ThaneGallo/GuitarPedal/(threads)

Thread 3 (2025-05-18):

Setup ADC within STM32 For testing

ThaneGallo, 2025-05-18:
After the initial amplifier is made and tuned you can begin testing to get the queues to move the data correctly

Just verify it moves from one place to another

Closed 2025-06-08.
