ThaneGallo/GuitarPedal/Code/Core/Src/main.c

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
/* Includes ------------------------------------------------------------------*/
#include "main.h"

/* USER CODE BEGIN Includes */

#include "PCM1802.h"
#include "dsp.h"



// #define ADC_BUF_LEN 16384
// #define HALF_BUF_LEN 8192

static uint16_t adc_buf[ADC_BUF_LEN];
static uint16_t dac_buf[ADC_BUF_LEN];

static float processing_buf[HALF_BUF_LEN];


// flags
uint8_t process_first_half = 0;
uint8_t process_second_half = 0;

/* USER CODE END Includes */

ADC_HandleTypeDef hadc1;
DMA_HandleTypeDef hdma_adc1;

DAC_HandleTypeDef hdac;
DMA_HandleTypeDef hdma_dac1;

TIM_HandleTypeDef htim2;

UART_HandleTypeDef huart2;

void SystemClock_Config(void);
static void MX_GPIO_Init(void);
static void MX_DMA_Init(void);
static void MX_ADC1_Init(void);
static void MX_USART2_UART_Init(void);
static void MX_TIM2_Init(void);
static void MX_DAC_Init(void);
/* USER CODE BEGIN 0 */

void myprintf(const char *fmt, ...)
{

  //	osStatus res = osMutexWait(USART_lockHandle, 1000);

  //	if(res == osOK){

  static char buffer[256];
  va_list args;
  va_start(args, fmt);
  vsnprintf(buffer, sizeof(buffer), fmt, args);
  va_end(args);

  int len = strlen(buffer);
  HAL_UART_Transmit(&huart2, (uint8_t *)buffer, len, -1);
}

//	osMutexRelease(USART_lockHandle);

/* USER CODE END 0 */

/**
 * @brief  The application entry point.
 * @retval int
 */
int main(void)
{

  /* MCU Configuration--------------------------------------------------------*/

  /* Reset of all peripherals, Initializes the Flash interface and the Systick. */
  HAL_Init();

  /* Configure the system clock */
  SystemClock_Config();

  /* Initialize all configured peripherals */
  MX_GPIO_Init();
  MX_DMA_Init();
  MX_ADC1_Init();
  MX_USART2_UART_Init();
  MX_TIM2_Init();
  MX_DAC_Init();
  /* USER CODE BEGIN 2 */
  uint32_t i;
  uint8_t dac = 0;

  myprintf("Start of start adc\n");

  // begins filling of ADC buffer
  HAL_TIM_Base_Start(&htim2);
  HAL_ADC_Start_DMA(&hadc1, (uint32_t *)adc_buf, ADC_BUF_LEN);

//  filter *lowpass_test = malloc(sizeof(filter));
//  filter *highpass_test = malloc(sizeof(filter));
//  filter *bandstop_test = malloc(sizeof(filter));
//  create_filter(lowpass_test, LOW_PASS_FILTER, 2, 1, 80);
////  create_filter(highpass_test, HIGH_PASS_FILTER, 2, 1, 200);
//  create_filter(bandstop_test, BAND_STOP_FILTER, 2, .7, 60);

  delay* delay;
  delay = malloc(sizeof(delay));
  create_delay(delay, 50);


  /* USER CODE END 2 */

  /* Infinite loop */
  /* USER CODE BEGIN WHILE */
  while (1)
  {
    /* USER CODE END WHILE */

    /* USER CODE BEGIN 3 */

    /*
     *
     * ADC buffer triggers at every half so first half can be processed while second half is being filled
     *
     * DAC buffer only begins once it is fully filled after the adc runs one full cycle
     *
     */

    // triggers when adc buff is half full
    if (process_first_half == 1)
    {

    //prepare data for dsp

      normalize_adc(processing_buf, adc_buf, HALF_BUF_LEN); //shift from 0-->4096 to -1 to 1


      process_delay(processing_buf, delay, .5);


      prepare_for_dac(&dac_buf, processing_buf, HALF_BUF_LEN);
//
//      //copy data into dac buffer
//      memcpy(&dac_buf, processing_buf, HALF_BUF_LEN * sizeof(uint16_t));

      process_first_half = 0;
    }
    // triggers once the second half is filled
    if (process_second_half == 1)
    {

//      dc_block(&adc_buf[HALF_BUF_LEN], HALF_BUF_LEN);
      normalize_adc(processing_buf, &adc_buf[HALF_BUF_LEN], HALF_BUF_LEN); //shift to -1 --> 1
//

      process_delay(processing_buf, delay, .5);

      //shifts back to
      prepare_for_dac(&dac_buf[HALF_BUF_LEN], processing_buf, HALF_BUF_LEN);

//      //copy data into dac buffer
//      memcpy(&dac_buf[HALF_BUF_LEN], processing_buf, HALF_BUF_LEN * sizeof(uint16_t));

      if (dac == 0)
      {
        HAL_DAC_Start_DMA(&hdac, DAC_CHANNEL_1, (uint32_t *)dac_buf, ADC_BUF_LEN, DAC_ALIGN_12B_R);
        dac = 1;
      }

      process_second_half = 0;
    }
  }

  /* USER CODE END 3 */
}

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
/**
 * @brief  Period elapsed callback in non blocking mode
 * @note   This function is called  when TIM1 interrupt took place, inside
 * HAL_TIM_IRQHandler(). It makes a direct call to HAL_IncTick() to increment
 * a global variable "uwTick" used as application time base.
 * @param  htim : TIM handle
 * @retval None
 */
void HAL_TIM_PeriodElapsedCallback(TIM_HandleTypeDef *htim)
{
  if (htim->Instance == TIM1)
  {
    HAL_IncTick();
  }
}

/**
 * @brief  This function is executed in case of error occurrence.
 * @retval None
 */
void Error_Handler(void)
{
  /* USER CODE BEGIN Error_Handler_Debug */
  /* User can add his own implementation to report the HAL error return state */
  __disable_irq();
  while (1)
  {
  }
  /* USER CODE END Error_Handler_Debug */
}

#ifdef USE_FULL_ASSERT
/**
 * @brief  Reports the name of the source file and the source line number
 *         where the assert_param error has occurred.
 * @param  file: pointer to the source file name
 * @param  line: assert_param error line source number
 * @retval None
 */
void assert_failed(uint8_t *file, uint32_t line)
{
  /* USER CODE BEGIN 6 */
  /* User can add his own implementation to report the file name and line number,
     ex: printf("Wrong parameters value: file %s on line %d\r\n", file, line) */
  /* USER CODE END 6 */
}
#endif /* USE_FULL_ASSERT */
