ThaneGallo/GuitarPedal/(commit log)

2025-05-18 added initial repo for STM32 project and added tasks for start ADC and Process Data
2025-05-19 #3 buffer is filled and interrupts trigger but adc reads as all 0s currently just moves data from tx to rx
2025-05-19 adc works #3
2025-05-24 removed all singular filters and created one process fliter as it uses generalized iir also sounds much better after band pass at 60hz
2025-12-30 Begin Analog Design documentatio
    Document considerations for passive components in analog design, including capacitors, resistors, and power sources.
